pretendancers/pretendancers.github.io/README.md

# ptdc.site

source files for ptdc.site

powered by vitepress
