pretendancers/pretendancers.github.io/src/docs/cheerz/downloads.md

# Downloads

## Open-Source Files

***You may need to right-click to download***

<a href="https://raw.githubusercontent.com/pretendancers/pretendancers.github.io/refs/heads/main/public/plates/ortholinear.dxf" download="ortholinear.dxf">Ortholinear Plate (DXF)</a>

<a href="https://raw.githubusercontent.com/pretendancers/pretendancers.github.io/refs/heads/main/public/plates/staggered.dxf" download="staggered.dxf">Staggered Plate (DXF)</a>

<a href="https://raw.githubusercontent.com/pretendancers/pretendancers.github.io/refs/heads/main/public/plates/universal.dxf" download="universal.dxf">Universal Plate (DXF)</a>

## Firmware

### **v2025-03 - Default firmware on shipment**

<a href="https://raw.githubusercontent.com/pretendancers/pretendancers.github.io/refs/heads/main/public/firmwares/Cheerz-vial_202503.uf2">Cheerz-vial_202503.uf2</a>

- Added key Overrides
- Layer count expanded to 16
- Native Vial lighting tab

### **v2025-11**

<a href="https://raw.githubusercontent.com/pretendancers/pretendancers.github.io/refs/heads/main/public/firmwares/Cheerz-vial_202511.uf2">Cheerz-vial_202511.uf2</a>

<a href="https://raw.githubusercontent.com/pretendancers/pretendancers.github.io/refs/heads/main/public/firmwares/Zoro-kbd-2.4G-Receiver_202510.uf2">Zoro-kbd-2.4G-Receiver_202510.uf2</a>

- ***<font color='red'>Before upgrading the keyboard firmware, please first update the 2.4g dongle firmware to version 2025-10.</font>*** ***[-> Instruction](./configuration.md#dflash)***
- Rebuilt from the latest Vial source code with new Vial features.
- Keymap is now saved automatically on changes; the [S_DATA] key has been removed.
- **Flashing new firmware will reset your layouts. Therefore, please save your layout beforehand and ensure it <font color='red'>contains no S_DATA key</font>.**
