pretendancers/pretendancers.github.io/src/docs/cheerz/contents.md

# Contents

Remove the plastic seal and slide off the outer sleeve, then open the magnetic cover. The package includes the following items:

## 01 - Main Components
1. **Keyboard Case**

	Top and bottom case set with pre-installed parts:
		
	- USB-C daughterboard
	- Short FFC (16.5 mm, same-way)
	- Magnetic daughterboard
	- Magnetic daughterboard retaining cover
	- Light diffuser

2. **Main PCB**

	Packed in an anti-static, ESD-safe bag.

3. **Switch Plate**

	Plate for universal, ortholinear or staggered layout, packaged in a resealable bag

4. **Foam Kit**
	
	- PORON case foam
	- PORON PCB foam
	- IXPE switch foam
	- PORON plate foam (three variants matching the plate layouts)

## 02 - Accessories

1. **Resealable Bag I (Screws)**

	- **M2 Hex Socket Screws ×14 (spares, for internal mounting)**

	- **M3 Hex Socket Screws ×8 (spares, for case assembly)**

2. **Resealable Bag II**  

	- **Silicone gaskets ×12 (8 used, 4 spares)**

	- **Light-blocking foam rings ×3 (1 used, 2 spares; adhesive-backed)**

	- **Short FFCs ×3 (16.5mm, same-way; spares)**

3. **Resealable Bag III**  

	- **Li-ion Batteries ×2 (Optional)**
		- Electrical: 3.7 V, 1400 mAh, 5.18 Wh,
		- Dimensions: 60 × 32 × 5 mm,
		- Cable: 25 mm length, MX1.25 51146 connector, 2-pin, ultra-thin

4. **Resealable Bag IV**  

	- **Long FFCs ×2 (60 mm, reverse; spares)**

		<font color=Red>**WARNING** For alternative wired installation only. Do not connect to magnetic daughterboard!</font>
	 
	- **Magnetic daughterboard retaining cover ×1 (spare, black FR4)**

	- **Magnetic daughterboard bottom foam ×1 (spare, adhesive-backed)**

	- **Adhesive foot pads ×16 (8 white, 8 black, 12 mm Ø × 2 mm thick)**

## 03 - Others

- **1.25mm Magnetic hex key ×1 (for M2 screws; may require magnetization before first use.)**

- **2.5mm Magnetic hex key ×1 (for M3 screws; may require magnetization before first use.)**

- **Cheerz washi tape ×1**

- **PCB socket reference card ×1 (includes QR code to this site)**

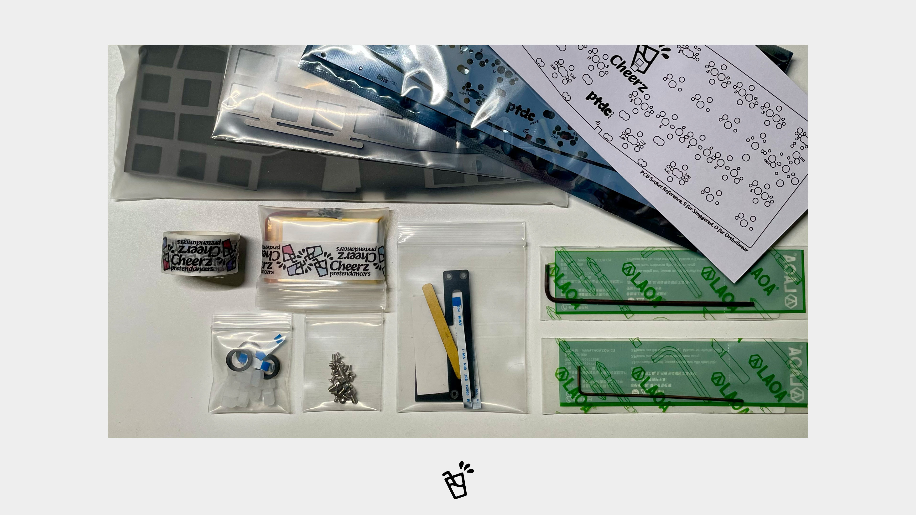
[picture p9: docs/contents/contents.jpg]


## 04 - Summary List

- Top-bottom case set ×1 (with pre-installed parts)
- Main PCB ×1
- Switch plate ×1
- Foam set ×1 (PORON & IXPE)
- M2 screws ×14 (spare) + M3 screws ×8 (spare)
- Silicone gaskets ×12 (8 used, 4 spares)
- Light-blocking foam rings ×3 (1 used, 2 spares)
- FFCs: Short ×3 (spare) + Long ×2 (spare)
- Li-ion batteries ×2 (optional)
- Magnetic daughterboard retaining cover ×1 (spare)
- Magnetic daughterboard bottom foam ×1 (spare)
- Adhesive foot pads ×16
- Magnetic hex key ×2 (1.25 mm & 2.5 mm)
- Cheerz washi tape ×1
- PCB socket reference card ×1
