pretendancers/pretendancers.github.io/src/docs/zh/cheerz/contents.md

# 包装清单

拆开塑封抽出封套，翻开磁吸盖后，包装内应有以下内容：

## 01 - 主体
1. **键盘外壳**

	拧好螺丝的上下盖已经预安装：
		
	- C口小板
	- 短排线
	- 磁吸小板
	- 磁吸盖板
	- 上盖匀光件

2. **PCB母板**

	静电袋包装

3. **定位板**

	自封袋包装，有通用/直列/斜列三种

4. **内胆棉**

	- PORON底棉
	- PORON轴座棉
	- IXPE轴下垫
	- PORON夹心棉:跟随定位板的不同分三种

## 02 - 配件

1. **自封袋1**

	- **M2内六角螺丝 ×14（备用，内部螺丝）**
		
	- **M3内六角螺丝 ×8（备用，上下盖螺丝）**

2. **自封袋2**  

	- **硅胶粒 ×12（用8个，4个备用）**

	- **遮光棉 ×3（用1个，2个备用；环形背胶）**

	- **短排线 ×3（16.5mm，同向8pin；备用）**

3. **自封袋3**  

	- **2 × 锂电池**
		- 规格：3.7 V, 1400 mAh, 5.18 Wh
		- 尺寸：60 x 32 x 5 mm
		- 接口：25mm线长，MX1.25 51146 超薄接口，正向2pin

4. **自封袋4**  

	- **长排线 ×2（60mm，反向8pin；备用）**

		<font color=Red> <b> 注意：长排线请勿连接磁吸小板! </b> </font>
	
	- **磁吸盖板 ×1（备用，黑色FR4）**

	- **磁吸小板底棉 ×1（备用，条形背胶）**

	- **脚贴 ×16（8白，8黑，12 mm Ø × 2 mm厚）**

## 03 - 其他

- **1.25mm磁吸内六角扳手 ×1（M2螺丝用，拆开时可能磁性较弱，使用前可以先进行磁化）**

- **2.5mm磁吸内六角扳手 ×1（M3螺丝用，拆开时可能磁性较弱，使用前可以先进行磁化）**

- **Cheerz和纸胶带 ×1**

- **PCB轴体安装参考卡 ×1 （背面有网站二维码）**



## 04 - 汇总

- 上下盖 ×1（已经预安装）
- PCB母板 ×1
- 定位板 ×1
- 棉 ×1
- M2内六角螺丝 ×14，M3内六角螺丝 ×8 - 全部备用
- 硅胶粒 ×12 - 用8粒，4粒备用
- 遮光棉 ×3 - 用1片，2片备用
- 短排线 ×3 - 备用
- 锂电池 ×2 - 可选安装
- 长排线 ×2- 备用
- 磁吸盖板 ×1- 备用
- 磁吸小板底棉 ×1 - 备用
- 脚贴 ×16 - 自行选用
- 磁吸内六角扳手 ×2 （1.25 mm + 2.5 mm）
- Cheerz 和纸胶带 ×1
- PCB轴座朝向参考 ×1
