pretendancers/pretendancers.github.io/src/docs/index.md

---
layout: home

hero:
    name: pretendancers
    text: Smaller is Superior
    tagline: Superior is Smaller
    # image: {
    #     light: "/ptdc_hero.png",
    #     dark: "/ptdc_hero_off.png"
    # }
    image: 
        src: "/about/ptdc_hero.png"
    actions:
        -   theme: brand
            text: START
            link: "./cheerz/layouts.md"
        -   theme: alt
            text: Downloads
            link: "./cheerz/downloads.md"
        -   theme: alt
            text: ੭ ᐕ)੭*⁾⁾
---
