pretendancers/pretendancers.github.io/src/docs/zh/index.md

---
layout: home

hero:
    name: pretendancers
    text: 小就是好
    tagline: 好就是小
    image:
        src: /about/ptdc_hero.png
    actions:
        -   theme: brand
            text: 开始
            link: "./cheerz/layouts.md"
        -   theme: alt
            text: 下载
            link: "./cheerz/downloads.md"
        -   theme: alt
            text: ੭ ᐕ)੭*⁾⁾
            link: "https://qm.qq.com/q/q1S6PJbN5I"
---
