pretendancers/pretendancers.github.io/src/docs/zh/cheerz/downloads.md

# 下载支持

## 开源文件

***可能需要右键选择下载***

<a href="https://raw.githubusercontent.com/pretendancers/pretendancers.github.io/refs/heads/main/public/plates/ortholinear.dxf" download="ortholinear.dxf">直列定位板 (DXF)</a>

<a href="https://raw.githubusercontent.com/pretendancers/pretendancers.github.io/refs/heads/main/public/plates/staggered.dxf" download="staggered.dxf">斜列定位板 (DXF)</a>

<a href="https://raw.githubusercontent.com/pretendancers/pretendancers.github.io/refs/heads/main/public/plates/universal.dxf" download="universal.dxf">兼容定位板 (DXF)</a>

## 固件

### **v2025-03 - 期货发出时的默认固件**

<a href="https://raw.githubusercontent.com/pretendancers/pretendancers.github.io/refs/heads/main/public/firmwares/Cheerz-vial-202503.uf2">Cheerz-vial-202503.uf2</a>

- 新增 keyoverride
- 层数追加到16层
- 单独的原生vial灯光tab

### **v2025-11**

<a href="https://raw.githubusercontent.com/pretendancers/pretendancers.github.io/refs/heads/main/public/firmwares/Cheerz-vial_202511.uf2">Cheerz-vial_202511.uf2</a>

<a href="https://raw.githubusercontent.com/pretendancers/pretendancers.github.io/refs/heads/main/public/firmwares/Zoro-kbd-2.4G-Receiver_202510.uf2">Zoro-kbd-2.4G-Receiver_202510.uf2</a>

- ***<font color='red'>更新该版本键盘固件前请先更新接收器固件版本至2025-10</font>*** ***[-> 教程](./configuration.md#dflash)***
- 基于最新Vial源码版本重新编译，更新相应新功能
- 键位跟随修改自动保存，S_DATA手动保存键值移除
- **更新键盘固件后键位会重置，请在刷机前保存键位并确保配置中<font color='red'>没有S_DATA键</font>**
