pretendancers/pretendancers.github.io/src/docs/zh/cheerz/layouts.md

# 配列布局

Cheerz的配列在vial中有六个选择框，对应了键盘六处不同的配列选择，分别是

- 第一行左半行（下图<font color="#D4C7E0">**紫色**</font>部分）
- 第一行右半行（下图<font color="#B0C7E6">**蓝色**</font>部分）
- 第三行左半行（下图<font color="#BCE4E0">**青色**</font>部分）
- 第三行右半行（下图<font color="#C0EDD2">**绿色**</font>部分）
- 空格行左半行（下图<font color="#EFEBCF">**黄色**</font>部分）
- 空格行右半行（下图<font color="#E3C4C6">**粉色**</font>部分）



<center><font size=2>配列图</font></center>

它们在vial中Layout的选项下为六个各自独立的选择框



- 第一行左半行可选斜列/直列



- 第一行右半行可选
  - 斜列：1.25回车、2.25回车、7回和BAE
  - 直列：1.25回车和2.25回车

*注：BAE需将实际触发的轴体安装在ANSI回车轴位上*



- 第三行左半行可选斜列/直列



- 第三行右半行可选斜列/直列



- 空格行左右都可以独立选择1u+2.25u或1.25u+2u的组合



综合六个区块均可独立选取，根据需求的不同可以任意搭配出适合自己的独特配列
