pretendancers/pretendancers.github.io/src/docs/_bkp/zh/index.md

---
layout: home

hero:
    name: pretendancers
    text: 小就是好
    tagline: 好就是小
    image:
        src: /ptdc_hero.png
    actions:
        -   theme: alt
            text: ੭ ᐕ)੭*⁾⁾
---
