pretendancers/pretendancers.github.io/src/docs/_bkp/zh/cheerz/downloads.md

# 支持

## 固件链接
### 链接
### 刷机教程

## 定位板图纸

## 开源物料
