pretendancers/pretendancers.github.io/docs/about/0098.webp

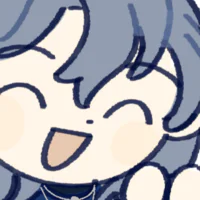
docs/about/0098.webp
