pretendancers/pretendancers.github.io/docs/about/earth.webp

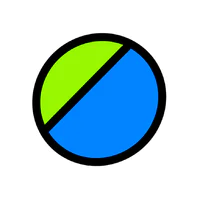
docs/about/earth.webp
