pretendancers/pretendancers.github.io/docs/about/ptdc_hero.png

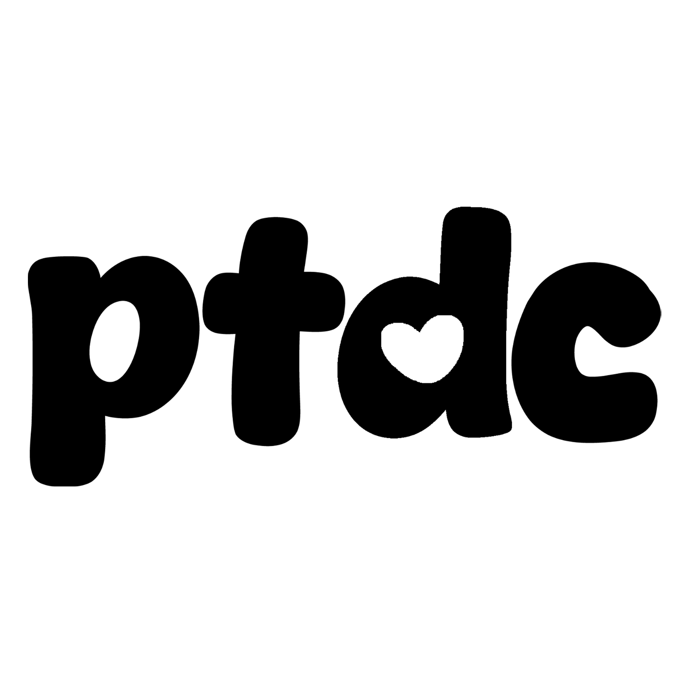
docs/about/ptdc_hero.png
