pretendancers/pretendancers.github.io/public/plates/ortholinear.dxf

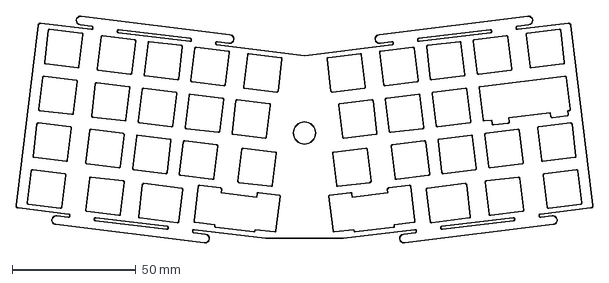
[picture p24: CAD file, 2025-05-28]
public/plates/ortholinear.dxf
232.9 x 91.6 mm
