pretendancers/pretendancers.github.io/public/plates/universal.dxf

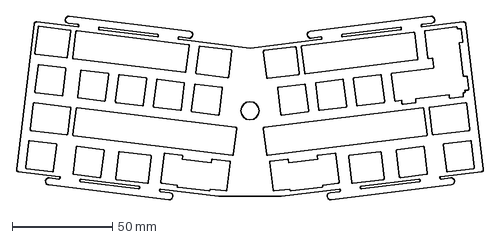
[picture p25: CAD file, 2025-05-28]
public/plates/universal.dxf
232.9 x 91.6 mm
