pretendancers/pretendancers.github.io/public/plates/staggered.dxf

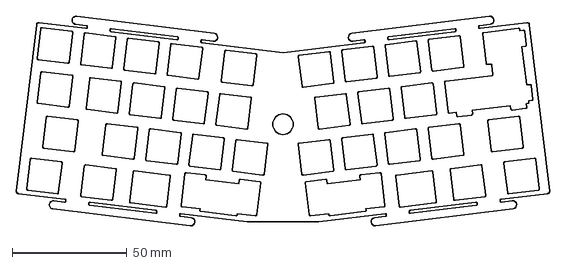
[picture p26: CAD file, 2025-05-28]
public/plates/staggered.dxf
232.9 x 91.6 mm
