pretendancers/pretendancers.github.io/src/docs/zh/cheerz/assembly.md

# 安装指南

***键盘发出时已经预安装至 [02] ，请先拧开上下盖M3螺丝，分开上下盖，从 [03] 继续***

## 01 - 子板安装

- 在磁吸小板背面贴上绝缘棉
- 将c口小板和磁吸小板通过同向短排线连接
		
	&emsp;&emsp;连接时将接口的翻盖向上翻开，接入排线后盖回盖板固定排线。排线两端的补强板长度略有区别，但连接时无方向要求，只需要保证排线的蓝色补强板朝上即可。
	
	***注意使用<font color=red>同向短排线(两端的蓝色补强板在同一面，排线长16.5mm)</font>，并且连接时排线尽可能插紧***



- 将连接好的子板放入底壳中，c口小板用M2螺丝固定
- 磁吸小板放入槽中，盖上磁吸盖板并用M2螺丝固定

	***注意磁吸盖板缺口与底壳匹配朝上放置，以及螺丝孔位的沉孔侧朝上***



## 02 - 匀光件安装

- 将匀光件对准上盖中心的孔位，两侧用M2螺丝固定



## 03 - 电池安装

- 将电池按c口小板指示的正负极连接，电池落入两侧电池仓中

	***电池可以自由选择安装，不安装电池时可作单模键盘使用，但需要注意键位保存，具体见[键位配置](./configuration.md#keysave)***



## 04 - 内胆组装

- 将内胆在外部先安装完成，其中安装轴下垫时可以使用附赠的和纸胶带辅助将其固定在pcb上，使用附赠的pcb孔位参考查看对应的轴向



- 将环形背胶遮光棉固定在定位板中心的孔位上，建议使用镊子对准，让遮光棉完全遮住孔位即可

	***不安装遮光棉时，在内胆中会有少量漏光***



- 将硅胶粒塞在定位板上，共8个，可以先在这步之后安装好键帽



## 05 - 整体安装

- 将内胆对准底壳，磁吸接口将自动吸附上，注意使每颗硅胶粒完全落入底壳的槽中

	***这里可以先将内胆倾斜着对齐一侧（如下方）的gas槽后再盖下***



- 合上上盖，并使用M3螺丝固定上下盖，如果压紧时感到受力过大可能是硅胶粒没有全部落入槽内。



- 使用附赠的脚贴遮盖住螺丝孔位，脚贴规格为直径12mm，厚2mm，可以根据自己喜好自行购买其他规格替换



## <font color='red'> 06 - **备用有线安装方式**</font>

***当不使用磁吸方案时，pcb还备有备用的排线直连方案***

***<font color='red'>注意使用有线安装方案时需要先接排线后接电池，带电操作可能会烧毁排线</font>***

- 将备用的<font color='red'>反向长排线</font>一端接入c口小板，另一端穿过底棉和轴座棉接入pcb背面的排线座子中

***注意使用<font color=red>反向长排线(两端的蓝色补强板在不同面，排线长60mm)</font>，并且连接时排线尽可能插紧***



- 连接好排线后掀起底棉和轴座棉，按需接入两侧的电池



- 后续安装同上
