pretendancers/pretendancers.github.io/docs/_bkp/cheerz/assembly.html

Skip to content

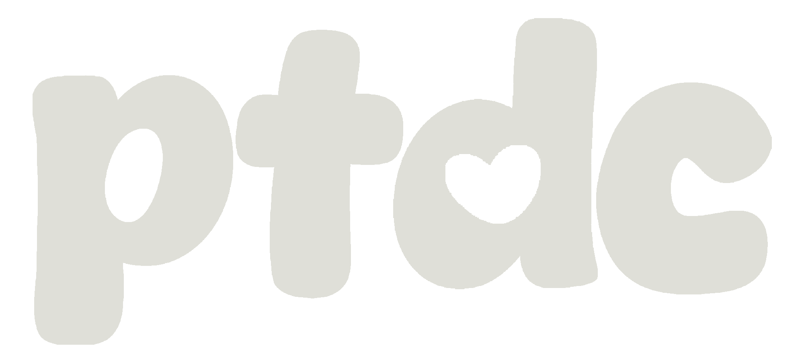
[picture p39: about/ptdc_off.png]
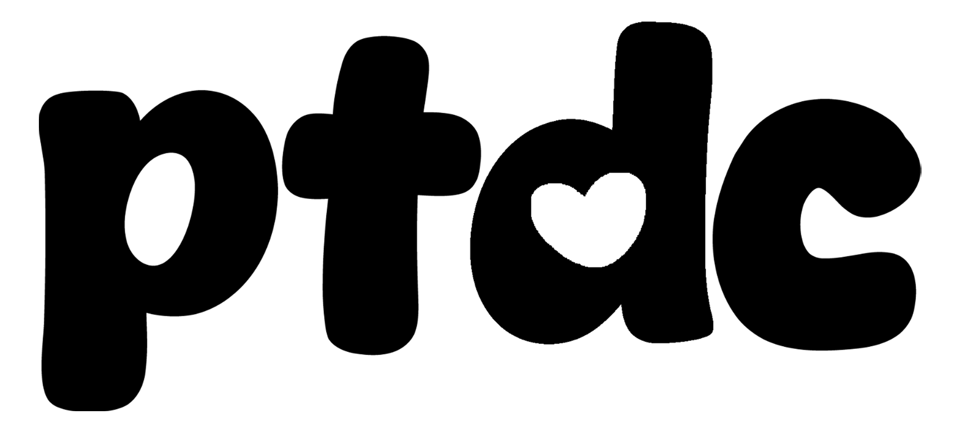
[picture p40: about/ptdc.png]
 

English

简体中文

English

简体中文

Appearance

Return to top

# Assembly

Last updated:

powered by VitePress

© 2024-present pretendancers (https://github.com/pretendancers)
