pretendancers/pretendancers.github.io/docs/_bkp/zh/cheerz/assembly.html

Skip to content

 

English

简体中文

English

简体中文

Appearance

Return to top

# 安装

## 推荐安装流程

## 注意事项

Last updated:

powered by VitePress

© 2024-present pretendancers (https://github.com/pretendancers)
